VroomDev/VroomRacer/display1.jpg

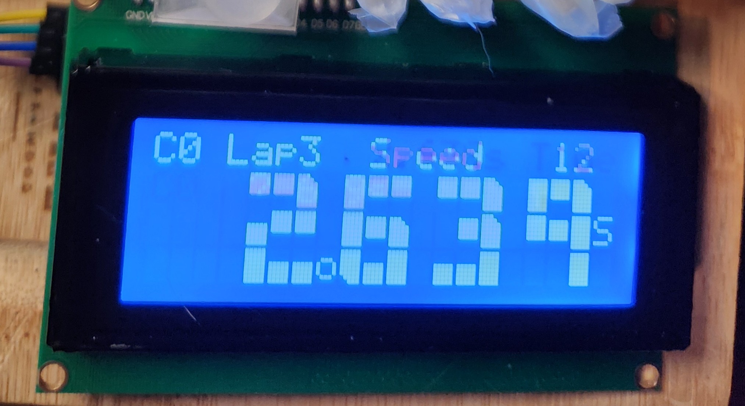
display1.jpg
