VroomDev/VroomRacer/img/speed-reaction.jpg

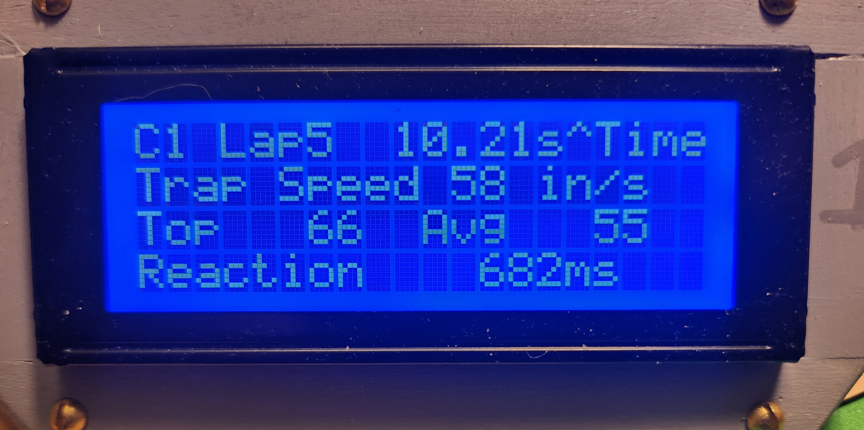
img/speed-reaction.jpg
