VroomDev/VroomRacer/Lcd.jpg

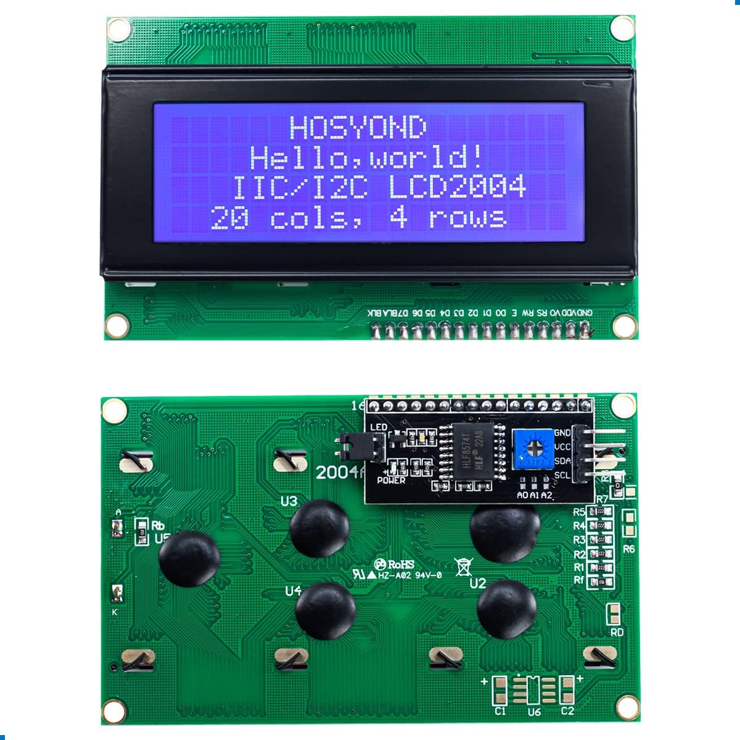
Lcd.jpg
