VroomDev/VroomRacer/wiringlooms.png

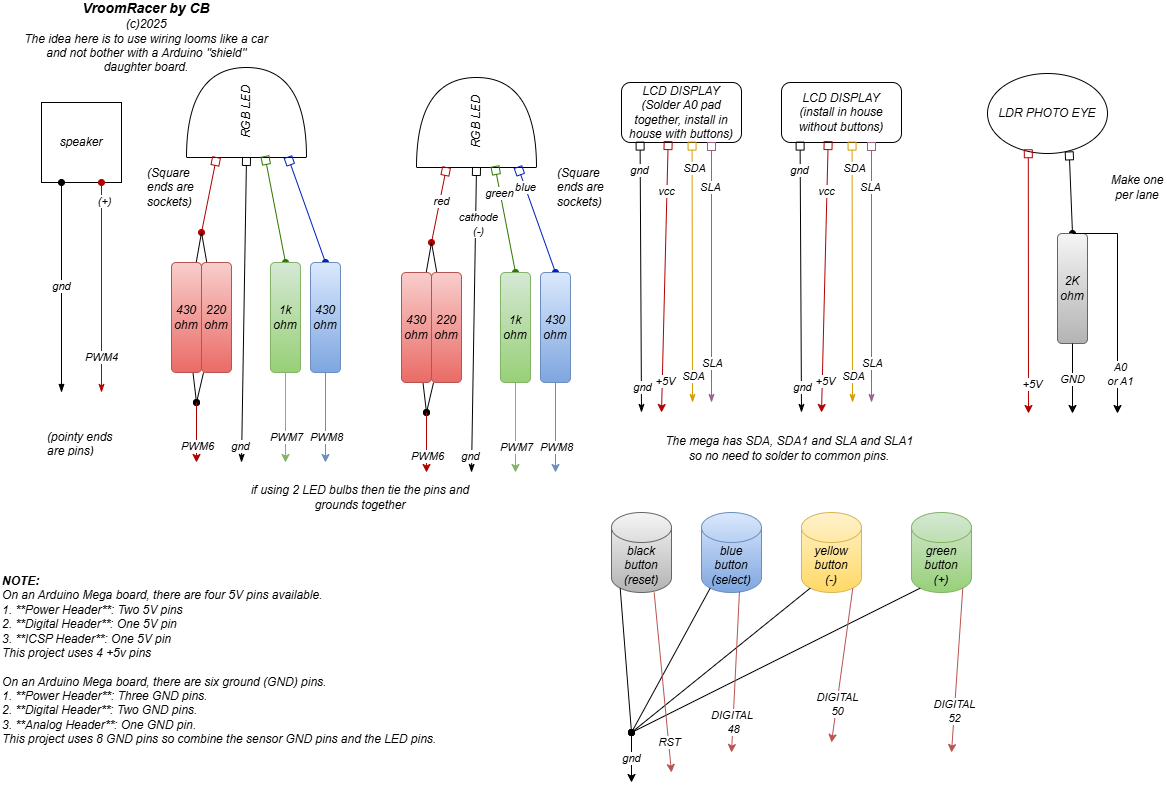
wiringlooms.png
