VroomDev/VroomRacer/VroomRacer.ino

/*
   Vroom Racer by Chris Busch
   (c) 2024

   Currently this project isn't broken into a compile+link arrangement.
   It is kept simple by simply using .h and not all the preprocessor
   controls.  That may change in the future if the code base grows.
   There are no warranties express or implied with this code.
   No guarantees of being fit for purpose.
*/

//////////////////////////// CONFIG VALUES
const char* title = "VroomRacer v20261014";


#define FUELSTEP 64
#define MINLAPDURSTEP 64
#define FRACTIONDENOM 8

typedef enum : uint8_t {RESUME, BANKMODE, BRIGHTNESS, SOUND, RACELEN, FUELING, COMPYELLOW, SPEEDLIMIT, MINLAPDUR, SERIALMONITOR, DEMODIAG, DEFAULTS,
                        YELLOWDELTA,
                        REDLAPSNUMER,
                        HOPTHRESHOLD,
                        BOPMODE,
                        NUMCONFIG
                       } Configs; //14 configs

uint8_t config[NUMCONFIG];
const char VLABELS[NUMCONFIG][22] PROGMEM =  {
  "- to Exit, + to Save\0", //
  "Boot up mode:       \0",
  "Brightness:         \0", //
  "Sound:              \0", //
  "Race length:        \0", //
  "Fuel(0=off):        \0", //
  "CompYellow Every:   \0", //
  "Yellow Spd limit:   \0", //
  "Min Lap Dur:        \0", //
  "Serial monitor:     \0", //
  "Demo/Diagnostics:   \0", //
  "Revert defaults?    \0", //
  "Yellow millis:      \0", //
  "Red Multiplier:     \0", //
  "Hop Thresold%:      \0", //
  "BOP Yellow:         \0"  //
  //01234567890123456789
};
#define NUMBANKS 4
typedef enum : uint8_t {FUELMODE, FASTMODE, TUNEMODE, DRAGMODE} ModeBanks;
const char* BANKNAMES[NUMBANKS] = {"Fuel", "Fast", "Tune", "Drag"};
#define BANKSIZE 128
uint8_t curBank = 0;
///////////////////////////////resume, mode, bright,    sound, laps, fuel, compy, limit, minlapdur, sermon, demo, defaults YelDel RedLaps  HOP BOP
const uint8_t VMAX[NUMCONFIG] = { 0,  NUMBANKS - 1,    8,       1,   99,   254,   99,    254,   254,      1,      1,    0,       254,  254, 95, 1 }; //max vmax is 254
const uint8_t VDEF[NUMBANKS][NUMCONFIG] = {
  //R Mode Br snd laps  fuel compyel limit  mLDur             Mon  DD  Def YellowDelta         redlaps   HOP BOP
  {0, 0,   8, 1,   10,   6,   5,      45,   2500 / MINLAPDURSTEP,  1,  0,   0, 2000 / MINLAPDURSTEP, 25, 75, 0}, //FUEL MODE
  {0, 0,   8, 1,   10,   0,   0,      45,   2500 / MINLAPDURSTEP,  1,  0,   0, 2000 / MINLAPDURSTEP, 25, 75, 0}, //Fast MODE
  {0, 0,   8, 0,   99,   0,   0,     254,  2500 / MINLAPDURSTEP,  1,  0,   0, 0, 0, 80, 0 }, //TUNE MODE
  {0, 0,   8, 1,   1,    0,   0,     254,   128 / MINLAPDURSTEP,  1,  0,   0, 0, 0, 0,0 }, //DRAG MODE
};

#define compYellowOn ((bool)config[COMPYELLOW]>0)
#define pitLaneSpeedLimit ((int)config[SPEEDLIMIT])
#define brightness ((int)config[BRIGHTNESS])
#define sound ((bool)config[SOUND])
#define minLapDuration ((int)config[MINLAPDUR]*MINLAPDURSTEP)
#define serialOn ((bool)config[SERIALMONITOR])
#define diagOn ((bool)config[DEMODIAG])
#define fuelOn ((bool)config[FUELING]>0)
#define dragOn (curBank==DRAGMODE)
#define MAXFUEL ((int)config[FUELING]*FUELSTEP)
#define raceLength ((int)config[RACELEN])
#define yellowDelta ((int)config[YELLOWDELTA]*MINLAPDURSTEP)
#define redLapsNumer ((int)config[REDLAPSNUMER])
#define hopThreshold ((int)config[HOPTHRESHOLD])
#define bopOn() ((bool)config[BOPMODE]>0)
////////////////////////////END OF CONFIG

const int NUMLANES = 2;


// Define an enum to represent different colors
typedef enum  {
  RED,
  GREEN,
  BLUE,
  YELLOW,
  ORANGE,
  PURPLE,
  CYAN,
  WHITE,
  BLACK,
  NUM_COLORS // Keeps track of the number of colors
} Color;


#include "pitches.h"
#define REST 0

typedef enum : char {FORMATION = 'F', SET = 'S', REDFLAG = 'R', YELLOWFLAG = 'Y', GREENFLAG = 'G', CHECKERS = 'C', DONE = 'D' } RaceFlag;


static uint8_t laneDisplayed = 0; //the last lane displayed on the screen if using 1 screen

//how fast to flip the display page
#define FLIPTIMEBOOST 20000
#define FLIPTIMELONG 10000
#define FLIPTIMESHORT 2000

int flipStayBoost = 0; //this makes the screen stay longer for a while.  Get's divided by 2 each time.

RaceFlag raceFlag = FORMATION;


//for debugging
#define ph(label)   if(serialOn){Serial.print(label);Serial.print(':');}
#define p(label,var) if(serialOn){Serial.print(label); Serial.print(':'); Serial.print(var); Serial.print(',');}
#define pln(label,var) if(serialOn){Serial.print(label); Serial.print(':'); Serial.print(var); Serial.println();}
#define ph2(label)   if(serialOn){Serial.print(label);Serial.print(':');}
#define p2(label,var) if(serialOn){Serial.print(label); Serial.print(':'); Serial.print(var); Serial.print(',');}
#define pln2(label,var) if(serialOn){Serial.print(label); Serial.print(':'); Serial.print(var); Serial.println();}


void mydtostrf(float value, int width, char (&buffer)[20]) {
  // Calculate the number of digits in the integer part of the value
  int intPart = abs((int)value);
  if (value > 99999 || value < -9999 ) {
    snprintf(buffer, 20, "OVER!"); //DANGER, could overflow if buffer is too small
    return;
  }
  int prec = 3;
  int digits = 1; //for dot
  if (intPart >= 1000) {
    digits += 4;
  } else if (intPart >= 100) {
    digits += 3;
  } else if (intPart >= 10) {
    digits += 2;
  } else if (intPart >= 1) {
    digits += 1;
  }
  while (prec > 0 && digits + prec > width) prec--; //reduce digit use if required
  // Use dtostrf with the adjusted precision
  dtostrf(value, width, prec, buffer);
}



// include the library code:

#include "MyLCD.h"
// initialize the library with the numbers of the interface pins
MyLCD lcd;

#include "Lights.h"


volatile int winner = -1;
volatile bool won = false; //race is over if true

unsigned long raceStart = 0,
              raceCheckersTime = 0; //the time the checkers flag first waved

volatile bool raceStarted = false;


#include "Detection.h"
#include "RingBuffer.h"


#include "MyTone.h"

// Create a Ring Buffer to hold Detection structs
const uint8_t bufferSize = 16; // Must be a power of 2
RingBuffer<Detection, bufferSize> ringBuffer;


#include "Sensor.h"
#include "ISR.h"
#include "Lap.h"
#include "Lane.h"

Lights lights;
Lane lanes[NUMLANES];

void setColor(Color c) {
  lights.setColor(c);
}

#include "Buttons.h"


void waveFlag(RaceFlag which) {
  raceFlag = which;
  switch (which) {
    case FORMATION:
      setColor(BLACK);
      break;
    case SET:
      setColor(WHITE);
      break;
    case REDFLAG:
      setColor(RED);
      break;
    case YELLOWFLAG:
      setColor(YELLOW);
      break;
    case GREENFLAG:
      setColor(GREEN);
      break;
    case CHECKERS:
      setColor(CYAN);
      break;
    default:
      setColor(BLACK);
  }
}

//#define TESTRBPS
#ifdef TESTRBPS

void testRBPS() {
  RingBuffer<Lap, 8> laps;
  Serial.println("testing ringbuffer pushSort, in reverse order");
  for (int i = 1; i < 15; i++) {
    Lap x;
    x.duration = 100 - i;
    x.lap = i;
    laps.pushSort(x);
    p2("i", i)
    for (int p = 0; p < 8; p++) {
      if (laps.bottom(x, p)) {
        p2(" p", p);
        p2("L", x.lap);
        p2("d", x.duration);
      }
    }
    pln2("", "");
    delay(500); //ok
  }
  delay(1000); //ok
  pln2("rbps", "now in order");
  laps.empty();
  for (int i = 1; i < 15; i++) {
    Lap x;
    x.duration = 100 + i;
    x.lap = i;
    laps.pushSort(x);
    p2("i", i)
    for (int p = 0; p < 8; p++) {
      if (laps.bottom(x, p)) {
        p2(" p", p);
        p2("L", x.lap);
        p2("d", x.duration);
      }
    }
    pln2("", "");
    delay(500);//ok
  }
  delay(1000);//ok
  pln2("rbps", "now in middle");
  laps.empty();
  for (int i = 1; i < 15; i++) {
    Lap x;
    if (i & 1) {
      x.duration = 100 + i;
    } else {
      x.duration = 110 - i;
    }
    x.lap = i;
    p2("i", i);
    p2("xd", x.duration);
    if (laps.pushSort(x)) {

      for (int p = 0; p < 8; p++) {
        if (laps.bottom(x, p)) {
          p2(" p", p);
          p2("L", x.lap);
          p2("d", x.duration);
        }
      }
      pln2("", "");
    } else {
      pln2("not", "pushed");
    }
    delay(500);//ok
  }
  delay(32000);//ok
}
#endif

void setup() {
  Serial.begin(9600);
  delay(50);//ok
  Serial.println("\n\nStarting");
#ifdef TESTRBPS
  testRBPS();
#endif

  if (scanDevices() == 0) {
    Serial.println("no LCD found");
  } else {
    for (int i = 0; i < nDevices; i++) {
      setDevice(i);
      lcd.boot(); //we need to configure the large font
      delay(100); //ok
    }
    lcd.demoBarChart();
    delay(500); //ok
    for (int i = 0; i < nDevices; i++) {
      setDevice(i);
      lcd.clear();
    }
  }
  //  Serial.println("speaker...");
  pinMode(speakerPin, OUTPUT);
  noTone(speakerPin);

  //  Serial.println("set up buttons...");
  setupButtons(); //NOTE THIS DOES THE CONFIG LOAD AS WELL
  Serial.print("analogRead A0:");
  Serial.println(analogRead(A0));
  delay(10); //ok
  Serial.print("analogRead A1:");
  Serial.println(analogRead(A1));
  delay(10);//ok
  if (dragOn) { //Set up drag racing
    NUMSENSORS = 4;
    Serial.println("NUMSENSORS TO 4");
    Serial.print("analogRead A2:");
    Serial.println(analogRead(A2));
    delay(10);//ok
    Serial.print("analogRead A3:");
    Serial.println(analogRead(A3));
    delay(10);//ok

  }

  //  Serial.println("set up lanes...");
  lanes[0].setup(0);
  lanes[1].setup(1);
  //  Serial.println("lights...");
  lights.setup(6, 7, 8); //MUST AVOID PINS: 9,10 ON MEGA see https://docs.simplefoc.com/choosing_pwm_pins
  //setting up display
  for (int d = 0; d < nDevices; d++) {
    setDevice(d);
    //////     /////01234567890123456789
    lcd.printRow(0, title);
    lcd.printRow(1, "Copyright 2024 by CB");
    lcd.setCursor(0, 2);
    lcd.print(BANKNAMES[curBank]);
    lcd.print(" Mode");
  }
  setDevice(0);
  ////////////
  ISR::setup();
  //////////
}


int loopc = 0;

#define AVG_CAR_LEN_INCHES 2.5
#define INCHMS_TO_INCHSEC 1000
// CONVERSION=AVG_CAR_LEN_INCHES*INCHMS_TO_INCHSEC
#define CONVERSION 2500
/// Very slow car example
//10:40:29.574 -> Detection:port:1,value:652,count:17432,timestamp:22000
//10:40:29.620 -> S#:1,mph:0.15,Sensor:acc:872,lastLapTime:22000,minAcc:866,maxAcc:873,count:0,initialThreshold:652,mainThreshold:435,ticks per ms:18,n:65535
// 2500*18/17432=2.58 inches/second

int curPage = 0;
long nextPageFlip = 0;
long nextFuelCheck = 0;
long nextStewardsCheck = 0;
long nextLogging = 0;

unsigned long compYellowStart = 0, compYellowStop = 0;
Detection d;
bool needReset = false;
bool lcdDark[MAXSENSORS];


void reset() {
  resetSensors();
  for (int i = 0; i < NUMLANES; i++) {
    lanes[i].reset();
  }
  winner = -1;
  won = false;
  raceStart = 0;
  raceStarted = false;
  curPage = 0;
  nextPageFlip = nextFuelCheck = nextStewardsCheck = 0;
  compYellowStart = 0;
  compYellowStop = 0;
  d.reset();
  needReset = false;
  ringBuffer.empty();
}

bool behind(int s){
  if( lanes[s].avgLapDur < 1 ) return false; //still on first lap or have yet to start
  if( lanes[(s + 1) % NUMLANES].avgLapDur < 1 ) return false; //still on first lap or have yet to start
  if( lanes[s].lapCounter < Lane::maxLapCounter ){
    ph("not on lead");
    p("lmpc",Lane::maxLapCounter);
    p("lslc",lanes[s].lapCounter);
    return true; //not on lead lap
  }
  //  if( lanes[s].avgLapDur > lanes[(s + 1) % NUMLANES].avgLapDur){
  //    p("going slower",lanes[s].avgLapDur);
  //    return true; //going slower
  //  }
  return false;
}

//bool ahead(int s){
//  if( lanes[s].avgLapDur < 1 ) return false; //still on first lap or have yet to start
//  if( lanes[(s + 1) % NUMLANES].avgLapDur < 1 ) return false; //still on first lap or have yet to start
//  if( lanes[s].lapCounter < Lane::maxLapCounter ) return false; //not on lead lap
//  if( ( lanes[s].avgLapDur < lanes[(s + 1) % NUMLANES].avgLapDur  ))  return true; //avg lap is faster
//  return false;
//}


void fueling() {
  if (fuelOn) {
    if ( millis() < nextFuelCheck) return;
    nextFuelCheck = millis() + 10;
    static int s = 0;
    s = (s + 1) % NUMSENSORS; //takes turns
    if (sensors[s].darkEnough && sensors[s].longEnough) {
      //in the sensor
      if (lanes[s].fuel < MAXFUEL) {
        if ( sensors[s].count > 250 * sensors[s].ticksPerMs) { //in pit
          // "Balance of Performance" (BoP) adjustment for solo fueling, since pit crew would work faster due to urgency
          nextFuelCheck = millis() + (lanes[s].lapCounter + 1 < Lane::maxLapCounter ? 60 : (lanes[s].lapCounter < Lane::maxLapCounter ? 120 : 180));
          lanes[s].fuel += MAXFUEL / ( bopOn() && behind(s) ? 10 : 20  )  + 1;
          if (lanes[s].fuel < MAXFUEL) {
            playToneNoBlock(400 + s * 300 + lanes[s].fuel, 2); //was playTone ,1
          } else {
            lanes[s].fuel = MAXFUEL;
            dingDing();
          }
          lanes[s].gasBanner();
          nextPageFlip = millis() + 500;
        }
      }
    }
  }
}

void loop() {
  loopc++;
  playMusicStep();
  delay(1);
  if (configByButtons()) {
    return; //stay in config mode
  }
  if ( minusButton()) {
    while (minusButton()) {
      delay(10); //wait for depress
    }
    nextPageFlip = 0;
    flipStayBoost = FLIPTIMEBOOST;
  }
  if ( (loopc & 255) == 0 && needReset) {
    lcd.setCursor(0, 3);
    ///////////01234567890123456789
    lcd.print("Please reset");
    for (int i = 0; i < 8; i++) {
      lcd.print(i < (loopc & 7) ? "." : " ");
    }
    return; //stop the loop
  }
  if (curBank == DRAGMODE) dragLoop();
  else raceLoop();
}

bool dragReady = false;



bool verbose = true;
//drag racing logic in here
void dragLoop() {
  if ((loopc & 511) == 510) {
    if (verbose) pln("NUMSENSORS", NUMSENSORS);
  }
  if ((loopc & 2047) == 0) {
    for (int i = 0; i < NUMSENSORS; i++) {
      if (verbose) p("S#", i);
      if (verbose) sensors[i].debug();
    }
  } else if ((loopc & 63) == 0) {
    for (int i = 0; i < NUMSENSORS; i++) {
      if (verbose) p(",", sensors[i].acc);
    }
    if (verbose) pln("<--", "Sensors");
  }
  if (! dragReady) {
    for (int i = 0; i < NUMSENSORS; i++) {
      if (sensors[i].n < 5000) {
        return;
      }
    }
    ISR::calcThresholds();
    dragReady = true;
    ISR::go();
  } else if (! raceStarted ) {
    if (plusButton()) {
      startDragRace();
    }
  } else {
    if ( plusButton()) {
      raceStarted = false; //do not have to wait for the other finisher
    }
    if (  ringBuffer.pull(d)) {
      handleDragDetection();
    }
  }
  updateDragLCD();
}

void handleDragDetection() {
  nextPageFlip = 0;
  d.debug();
  auto i = d.port;
  playToneNoBlock(400 + i * 300, 50);
  if (d.port < 2) { //start sensors
    if (!lanes[i].start.isEmpty()) {
      pln("already started", i);
      return; //ignore this as we already started!
    }
    lanes[i].start = d;
    auto speed = lanes[i].setSpeed(CONVERSION * sensors[d.port].ticksPerMs / d.count);
    p("port", d.port + 1);
    pln("ispeed", speed);
  } else { //finish sensors
    i -= 2;
    if (lanes[i].start.isEmpty()) {
      pln("not crossed start", i);
      return;  //we haven't crossed start
    }
    if (!lanes[i].finish.isEmpty()) {
      pln("we already finished", i);
      return; //ignore this as we already finished!
    }
    playToneNoBlock(400 + i * 300, 100);
    lanes[i].finish = d;
    auto speed = lanes[i].setSpeed(CONVERSION * sensors[d.port].ticksPerMs / d.count);
    lcd.setCursor(0, 0);
    lcd.print("C");
    lcd.print(i + 1);
    if (lanes[i].start.timestamp < raceStart) {
      //DQ
      lcd.print(  " is the DQed!!! ");
    } else if (won) {
      //didn't win :(
      lcd.print(  " finished.        ");
      //playEngine();
      waveFlag(DONE);
      raceStarted = false;
      curPage = 0;
    } else {
      won = true;
      winner = i;
      ///////////12345678901234567890
      waveFlag(CHECKERS);
      lcd.print(  " is the WINNER!!! ");
    }
  }
}


//  01234567890123456789
//0 VroomRacer v20250102
//1 Instructions
//2 C1 R1234 E91234 S123
//3 C2 R1234 E91234 S123

void updateDragLCD() {
  static uint8_t flipper = 0; //drag lcd
  if (millis() > nextPageFlip) {
    nextPageFlip = millis() + FLIPTIMELONG;
    if (nDevices > 0) {
      setDevice(0);
      lcd.printRow(0, title);
      lcd.printRow(1, won ? "Race complete!" : (raceStarted ? "Go!" : "Press + to Drag Race"));
      lanes[++flipper % NUMLANES].display1Drag();
      lanes[++flipper % NUMLANES].display1Drag();
    }
    curPage = ++curPage >= PAGECOUNT ? 0 : curPage;
  }
}

void alertDragDetection(int i) {
  if (! lanes[i].detect(d) ) {
    alertDragBadDetection(i, lanes[i].why);
    return;
  }
  pln("GOOD LAP car:", i);
  playToneBlocking(400 + i * 300, 100);
  lanes[i].banner0(true, "");
  nextPageFlip = millis() + FLIPTIMESHORT;
  if (lanes[i].lapCounter == raceLength) {
    lcd.setCursor(0, 0);
    lcd.print("C");
    lcd.print(i + 1);
    if ( winner == lanes[i].laneNum ) {
      ///////////12345678901234567890
      waveFlag(CHECKERS);
      lcd.print(  " is the WINNER!!! ");
      //playMusic(odeToJoyMelody,odeToJoyNotes,80*4);
    } else {
      lcd.print(  " finished.        ");
      //playEngine();
      waveFlag(DONE);
      raceStarted = false;
      curPage = 0;
    }
  }
  waveFlag(raceFlag);
}

/** param i is the car lane */
void alertDragBadDetection(int i, const char* msg) { //,Detection& d){
  nextPageFlip = millis() + FLIPTIMESHORT;
  p("BAD LAP car:", i);
  pln("msg:", msg);
  lanes[i].fouls++;
  lanes[i].banner(false, msg);
  for (int t = 0; t < 90; t += 10) {
    playToneBlocking(400 + i * 300 - t, 20);
  }
  waveFlag(raceFlag);
  lanes[i].prior = d; //reset start of this lap
}


extern volatile unsigned long timer0_millis;

void resetClock() {
  //  noInterrupts();
  //  timer0_millis=0;
  //  interrupts();
}

void startDragRace() {
  resetClock();
  lcd.printRow(0, title);
  lcd.printRow(1, "Get ready.");
  lcd.printRow(2, "");
  lcd.printRow(3, "");
  while (plusButton()) {
    delay(10); //wait for depress
  }
  reset();
  delay(1000); //debounce
  // Print a message to the LCD.
  /////     //////01234567890123456789
  lcd.printRow(1, "Get set.");
  playF1StartSound1(); //drag
  raceStart = millis();
  auto chk = checkSensors();
  if (chk >= 0) {
    lcd.setCursor(0, 2);
    lcd.print("Sensor fault:");
    lcd.print(chk);
    lcd.print(" ");
    lcd.printRow(3, "Please reset.");
    playToneBlocking(250, 100);
    needReset = true;
    delay(100); //drag
    return;
  } else {
    raceStarted = true;
  }
  waveFlag(GREENFLAG);
  playToneBlocking(1000, 500);
  ///////////01234567890123456789
  lcd.printRow(1, "GO!!!!!!!!");
}

void logging() {
  if (millis() > nextLogging) { //STEWARDS
    nextLogging = millis() + 511;
    for (int i = 0; i < NUMSENSORS; i++) {
      p("S#", i);
      sensors[i].debug();
    }
  }
}

void checkFinishLine() {
  if (  ringBuffer.pull(d)) {
    //nextPageFlip=0;
    auto i = d.port;
    auto aspeed = lanes[i].avgSpeed();
    auto speed = lanes[i].setSpeed(CONVERSION * sensors[d.port].ticksPerMs / d.count);
    if (serialOn) {
      pln("-----------------NEW DETECTION-------------", "");
      p("C#", d.port);
      sensors[d.port].debug();
      d.debug();
      p("avgSpeed", aspeed);
      pln("inch/sec", speed);
    }
    if (lanes[i].lapCounter >= raceLength) { //driver done with race
      alertGoodLap(i);
    } else if ( d.flag == REDFLAG ) { //lap doesn't count
      alertBadLap(i, "Red Flag");
    } else if (d.flag == YELLOWFLAG) { // need to make sure going slowly through trap
      if ( speed <= pitLaneSpeedLimit ) { //lap counts
        alertGoodLap(i);
      } else { // too fast!
        alertBadLap(i, "Too fast!");
      }
    } else { //lap is green
      alertGoodLap(i);
    }
  }
}

void checkStewards() {
  if (millis() > nextStewardsCheck) { //STEWARDS
    nextStewardsCheck = millis() + 231; // try to have the time offset be relatively prime compared with others
    //check for yellows
    bool anyYellow = false, anyRed = false;
    if (!won) {
      // if we are in a red flag situation, stay red.  Otherwise check to see if in comp yellow period.
      if (compYellowOn && raceFlag != REDFLAG && millis() > compYellowStart && millis() < compYellowStop) {
        if (raceFlag != YELLOWFLAG) {
          ph("Mid race competition yellow")
        }
        if (raceFlag == GREENFLAG) {
          ////////////////01234567890123456789
          lcd.printRowBoth(0, "Competition Yellow!");
          nextPageFlip += 1213;
        }
        anyYellow = true;
      } else {
        for (int i = 0; i < NUMLANES; i++) {
          //          ph("checkStewards:");
          //          p("i",i);
          //          p("ahead",ahead(i));
          //          pln("behind",behind(i));
          //is a car very late? definitely crashed
          //////////////////////////RED CHECK
          if ( !(sensors[i].darkEnough || sensors[i].longEnough) //make sure not in pitstop
               && redLapsNumer > 0
               && lanes[i].avgLapDur > 0
               && millis() > lanes[i].prior.timestamp + lanes[i].avgLapDur + yellowDelta + (lanes[i].avgLapDur * redLapsNumer / 100) //this one is late
               && millis() > lanes[(i + 1) % NUMLANES].prior.timestamp + lanes[(i + 1) % NUMLANES].avgLapDur / 2 ) { //this one is nearing start/finish
            //car is late, and the other is nearing start/finish
            if (raceFlag != REDFLAG && !anyRed && !anyYellow ) {
              p("Red flag detected Car late", (char)raceFlag)
              pln("Car", i);
            }
            if ( raceFlag != REDFLAG) {
              setDevice(i);
              lcd.printRowCentered(0, "Car is very late!");
              nextPageFlip += 1211;
            }
            anyRed = true;
            //is a car getting late, probably crashed
            //////////////////////////YELLOW CHECK
          } else if ( !(sensors[i].darkEnough || sensors[i].longEnough) //make sure not in pitstop
                      && yellowDelta > 0
                      && lanes[i].avgLapDur > 0
                      && millis() > lanes[i].prior.timestamp + lanes[i].avgLapDur + yellowDelta  //this one is late
                      && millis() > lanes[(i + 1) % NUMLANES].prior.timestamp + lanes[(i + 1) % NUMLANES].avgLapDur  / 2) { //this one is nearing start/finish
            //car is late!
            if (raceFlag != YELLOWFLAG && raceFlag != REDFLAG && !anyRed && !anyYellow) {
              p("Yellow detected Car late", (char)raceFlag)
              pln("Car", i);
            }
            if ( raceFlag != YELLOWFLAG) {
              setDevice(i);
              lcd.printRowCentered(0, "Car is late!");
              nextPageFlip += 1301;
            }
            anyYellow = true;
            //end else if 
          } else if ( !(sensors[i].darkEnough || sensors[i].longEnough) //make sure not in pitstop
                      && bopOn() && behind(i)
                      //&& lanes[i].avgLapDur > 0 //car has finished a lap
                      //&& lanes[(i + 1) % NUMLANES].avgLapDur > 0 //other car has finished a lap
                      && millis() < lanes[i].prior.timestamp + lanes[i].avgLapDur/2 //this car is in first half of lap
                      && millis() > lanes[(i + 1) % NUMLANES].prior.timestamp + lanes[(i + 1) % NUMLANES].avgLapDur  / 2) /* other car is in second half of lap*/ {
            if (raceFlag != YELLOWFLAG && raceFlag != REDFLAG && !anyRed && !anyYellow) {
              p("bop yellow", (char)raceFlag)
              pln("Car", i);
            }
            if ( raceFlag != YELLOWFLAG) {
              setDevice(i);
              playToneNoBlock(345, 50);
              lcd.printRowCentered(0, "BOP Yellow!");
              nextPageFlip += 1301;
            }
            anyYellow = true;
            //end else if 
          }
        }
      }
    }
    if (anyRed && (raceFlag == YELLOWFLAG || raceFlag == REDFLAG)) {
      if ( raceFlag != REDFLAG) {
        pln("wave", "red flag");
        playMusic(imperialMarchMelody, imperialMarchNotes, 3 * 120);
        raceFlag = REDFLAG;
        waveFlag(raceFlag);
        nextPageFlip = millis() + 1257;
        nextStewardsCheck = millis() + 1000;
      }
    } else if (anyYellow || anyRed) {
      if (raceFlag != YELLOWFLAG) {
        pln("wave", "yellow flag");
        playMusic(imperialMarchMelody, imperialMarchNotes, 120);
        raceFlag = YELLOWFLAG;
        waveFlag(raceFlag);
        nextPageFlip = millis() + 1265;
        nextStewardsCheck = millis() + 1000;
      }
    } else if (raceFlag == YELLOWFLAG || raceFlag == REDFLAG) { //go back to green!
      pln("back to", "green");
      /////////////////////01234567890123456789
      lcd.printRowBoth(0, "   Back to Green!");
      playF1Restart(); //
      waveFlag(FORMATION);
      raceFlag = GREENFLAG;
      waveFlag(raceFlag);
      nextPageFlip = millis() + 501;
      nextStewardsCheck = millis() + 500;
    }
  }
}

void raceLoop() {
  logging();
  if (!raceStarted) {
    // Print a message to the LCD.
    ///////////01234567890123456789
    lcd.printRowBoth(2, "   Get ready.       ");
    for (int i = 0; i < NUMLANES; i++) {
      lanes[i].fuel = MAXFUEL;
    }
    playF1StartSound1(); //road course
    ISR::calcThresholds();
    auto chk = checkSensors();
    if (chk >= 0) {
      lcd.setCursor(0, 2);
      lcd.print("Sensor fault Lane:");
      lcd.print(chk);
      lcd.print(" ");
      lcd.printRow(3, "Please reset.");
      playToneBlocking(250, 100);
      needReset = true;
      delay(100); //fault
      return;
    } else {
      ISR::go();
      raceStart = millis();
      raceStarted = true;
    }
    waveFlag(GREENFLAG);
    playToneNoBlock(1000, 500);
    ///////////01234567890123456789
    lcd.printRowBoth(3, "     GO!!!!!!!!     ");
    nextFuelCheck = millis() + 401;
    nextStewardsCheck = millis() + 513;
    nextPageFlip = millis() + 600;
  }
  checkFinishLine();
  fueling();
  checkStewards();
  updateLCD();
}


/**
   param i is the car lane
*/
void alertGoodLap(int i) {
  laneDisplayed = i;
  if (! lanes[i].detect(d) ) {
    alertBadLap(i, lanes[i].why);
    return;
  }
  p("fuel", lanes[i].fuel);
  pln("GOOD LAP car:", i);
  playToneBlocking(400 + i * 300, 100);
  if (lanes[i].fuel < MAXFUEL / 5) {
    ph("LOW FUEL");
    playToneBlocking(400 + i * 300 - 100, 50);
    delay(50); //low fuel ding ding
    playToneNoBlock(400 + i * 300 - 100, 50);
  }
  laneDisplayed = i;
  nextPageFlip = millis() + FLIPTIMESHORT; //assume something was displayed
  if (config[COMPYELLOW] > 0
      && ((lanes[i].lapCounter) % (1 + config[COMPYELLOW])) == (config[COMPYELLOW]) //happens every comp yellow lap
      && millis() > compYellowStop) { //only turn it on if the comp yellow is not active
    compYellowStart = millis() + (millis() & 0xFFF); //start in up to 4095ms or 4 seconds random amount
    compYellowStop = compYellowStart + lanes[i].avgLapDur + 1000; //make it last for 1 typical lap
  }
  if (lanes[i].lapCounter == raceLength ) { //simply to change the light eventually to off if enough laps ran
    if ( winner == lanes[i].laneNum ) {
      ///////////12345678901234567890
      waveFlag(CHECKERS);
    } else {
      waveFlag(DONE);
    }
  } else if (lanes[i].lapCounter > raceLength) {
    waveFlag(DONE); //enough laps ran, let's turn off light
  }
  waveFlag(raceFlag);
}

/**
   param i is the car lane
*/
void alertBadLap(int i, const char* msg) { //,Detection& d){
  laneDisplayed = i;
  nextPageFlip = millis() + FLIPTIMESHORT;
  p("BAD LAP car:", i);
  pln("msg:", msg);
  lanes[i].fouls++;
  lanes[i].banner(false, msg);
  laneDisplayed = i;
  for (int t = 0; t < 90; t += 10) {
    playToneBlocking(400 + i * 300 - t, 20);
  }
  waveFlag(raceFlag);
  lanes[i].prior = d; //reset start of this lap
}


/**
   During the race, show the banner() when the race is over call display() which is more informational.
*/
void updateLCD() {
  if (millis() > nextPageFlip) {
    nextPageFlip = millis() + FLIPTIMELONG + flipStayBoost;
    flipStayBoost /= 2;
    if ( !won && flipStayBoost == 0) { //force showing laps during race unless push button flipping
      if (nDevices == 1) { //just show the driver's screen
        for (int i = 0; i < NUMLANES; i++) {
          lanes[i].bannerShared("");
        }
      } else { //show both drivers
        for (int i = 0; i < NUMLANES; i++) {
          setDevice(i % nDevices);
          lanes[i].banner(true, "");
        }
      }
    } else { //post race informational
      if (nDevices == 1) {
        laneDisplayed = ++laneDisplayed % NUMLANES;
        lanes[laneDisplayed].display(curPage, raceFlag);
        if ( laneDisplayed == 0)  curPage = ++curPage >= PAGECOUNT ? 0 : curPage; //only change the page after both cars are displayed!
      } else {
        for (int i = 0; i < NUMLANES; i++) {
          setDevice(i % nDevices);
          lanes[i].display(curPage, raceFlag);
        }
        curPage = ++curPage >= PAGECOUNT ? 0 : curPage;
      }
    }
  }
}


////eof
