VroomDev/VroomRacer/attic/Ema.h

/////////Ema by Chris Busch
/*
 * Code by Chris Busch (c) 2024
 * There are no warranties express or implied with this code.
 * No guarantees of being fit for purpose.
 */
 
const float alpha = 2.0/(500+1); // Smoothing factor (0 < alpha <= 1)  
class Ema {
  public:

    volatile int learns=0;
    volatile float value=-1;

    float learn(float reading){
      if(value<0) value=reading;
      else value = (alpha * reading) + ((1 - alpha) * value);
      if(learns<32000) learns++;
      return value;      
    }

    float get(){
      return value;
    }
     
};
