VroomDev/VroomRacer/(commit log)

2024-12-20 missing photo events sadly
    [Ema.h, Lane.h, MyTone.h, VroomRacer.ino]
2024-12-24 Modified ISR to use proper flags. added more objects. Used a RingBuffer for interrupt to main code communication. Close to working. Needs tuning.
2025-01-05 Added automatic yellow detection and added race control LEDs. Conducted tests and passed the lap counting tests. Speed is computed as inches per second.
2025-01-14 jumped car detection now handles when 1 car crashes on the first lap since now uses the best of all/any racer
    [Lane.h]
2025-01-17 added reaction time. note, if a race is jump started, the sensor will not count the lap and hence an effective penalty
2025-01-20 deleted lane light indicators, added button configuration
2025-01-21 fixed null pointer bug, added more config, adding demo/diag. Needs another play test.
    [Buttons.h, Lane.h, Lights.h, MyLCD.h, VroomRacer.ino]
2025-01-26 fixed circuit drawing, added version number
    [Buttons.h, VroomRacer.ino]
2025-02-04 added another banner and fixed no fuel at tail end of lap not count bug
    [Lane.h]
2025-02-04 added print big string
2025-02-04 added banner flip and faster refueling
    [VroomRacer.ino]
2025-02-07 fixed laps banner overwrite
    [Lane.h]
2025-02-14 fixed 2 bugs: race length and interrupt fix in ringbuffer. added a display page that shows most recent lap times
    [Lane.h, Lap.h, RingBuffer.h, VroomRacer.ino]
2025-03-21 added set and reset functions
    [Detection.h]
2025-03-21 removed smoothing logic and added the ability to have more sensors
2025-03-21 fixed starting sound sequence
    [MyTone.h]
2025-03-21 added drag race display and reset
    [Lane.h]
2025-03-22 fixed up drag display and fixed added bug to yellow and red flags detection timing
    [VroomRacer.ino]
2025-03-25 added print reaction time
2025-05-26 added resetSensors and switched to 12 bit mode
    [ISR.h]
2025-05-26 Drag racing is functional with no bad bugs
    [VroomRacer.ino]
2025-05-26 Fixed DQ in drag racing display
    [Lane.h]
2025-07-20 if during race, pushes minus button, this scrolls through screens so you do not have to wait
2025-07-21 fixes for RingBuffer pushSort
    [RingBuffer.h]
2025-07-23 fixed worst lap logging
    [VroomRacer.ino]
2025-07-23 now records best, worst, PR correctly
    [Lane.h]
2025-09-20 fixed floating point display
    [VroomRacer.ino]
2026-03-02 cleaned up display logic further. Will only show statistics screens at the end of the race or unlesss someone pushes the yellow button
2026-03-21 fixed hidden median and checked in RingBuffer set function
    [Lane.h, RingBuffer.h]
2026-04-07 updates for enclosure
2026-04-25 Fix for Display not working
    [MyLCD.h, VroomRacer.ino]
2026-04-29 fixed start up sequence, gas banner for single vs two screens. early indication of custom font
    [Lane.h, MyLCD.h, VroomRacer.ino]
2026-05-08 Update MyLCD.h hopefully fixes poor display
    [MyLCD.h]
2026-05-08 Update MyLCD.h added wire speed diagnostic
2026-05-08 switched lcd libraries
2026-05-08 fixed buttons h
2026-05-11 added center printing
2026-05-11 made race loop more time stable by doing millis tracked waiting between checks
2026-06-06 fix for red yellow toggling
    [VroomRacer.ino]
